balewski/plant_lineFollower/docs/line_folower_figs/section_electrical_robot.tex

\clearpage
\section{Electrical Connections and Onboard I/O}
\label{sec:electrical-design}
\subsection{Shared Battery and Two Power Rails}
The recorded wiring uses one shared two-cell 18650 pack (2S, 7.4\,V nominal), with separate 5\,V logic and 6\,V motor buck converters. S1 enables the logic branch and feeds the downstream S2 motor switch. Opening S2 removes motor power while leaving computing and sensing powered. Desktop and ASUS use their own external supplies.

\begin{figure}[H]
\centering
\input{current_robot_power.tikz}
\caption{Current power topology. One battery feeds two converters; this replaces the earlier independent-power-bank concept. Grounds join on the load side of the return ammeter. Pi--Teensy control data uses 3.3\,V UART, not USB CDC.}
\label{fig:power_topology}
\end{figure}

The 5\,V output feeds Pi, Teensy Vin and all three sensor VCC inputs in parallel. Teensy's USB power bridge is cut to isolate VUSB from Vin. Teensy 3.3\,V feeds TB6612FNG VCC; the 6\,V buck feeds VM. Motor leads connect across each bridge's two outputs, not to ground. Converter capacity, motor stall current and pack discharge performance remain uncharacterized in this record.

All signal grounds share a reference. Route motor current back to the motor buck rather than through Teensy or sensor ground leads. The detailed diagram omits charging/protection and bypass components. Retain the documented local bypassing and motor suppression; the earlier recommendation was a 470--1000\,$\mu$F motor-rail bulk capacitor and 0.1\,$\mu$F across each motor, not a measured inventory of fitted parts.

\clearpage
\subsection{Pi, Teensy and Motor-Driver Wiring}
\begin{figure}[H]
\centering
\resizebox{.86\linewidth}{!}{\input{pi_teensy_tb6612_wiring.tikz}}
\caption{Pin-level motor wiring, timing connection and indicator LEDs. Channel A drives the left wheel; channel B drives the right wheel. Teensy pin 20 connects through 5\,k$\Omega$ to Pi GPIO23 (header pin 16) for shared-edge timing. Pi GPIO24 (header pin 18) and Teensy pin 21 each drive a separate grounded LED through 5\,k$\Omega$. S1 and S2 are cascaded; all grounds join the ammeter's load side.}
\label{fig:pi-teensy-tb6612-wiring}
\end{figure}

Pi GPIO14/TX (header pin 8) connects to Teensy pin 0/RX1. Pi GPIO15/RX (header pin 10) connects to Teensy pin 1/TX1. Both are 3.3\,V signals, with common ground. The current client opens \texttt{/dev/serial0} at 115200 baud, 8N1. USB is retained as a programming option, not the normal control-data path.

The timing wire is separate from UART: Teensy pin 20 is the pulse output and Pi GPIO23 is the input. Each indicator LED has its anode connected through its own 5\,k$\Omega$ resistor to its GPIO output and its cathode connected to common ground. Firmware revision 16 retains the standalone \texttt{measure\_pi\_teensy\_clock} test: both LEDs flash twice (0.5\,s on, 0.5\,s off), then numbered timing pulses compare Teensy timestamps with Pi kernel GPIO-event timestamps. Motors remain disabled. The reported offset applies no latency correction; the assumed 0.1\,ms allowance is not an independently verified accuracy bound.

\begin{table}[H]
\centering\small
\caption{Current dual-motor GPIO allocation in firmware revision 9.}
\label{tab:current-motor-pins}
\begin{tabular}{@{}L{4cm}L{3cm}L{9cm}@{}}
\toprule
Function & Teensy pins & Behavior \\
\midrule
Left motor A & PWM 3; direction 4, 5 & Signed command $-255\ldots255$; hardware PWM 20\,kHz. \\
Right motor B & PWM 9; direction 7, 8 & Signed command $-255\ldots255$; hardware PWM 20\,kHz. \\
Common standby & 6 & LOW disables both bridges; \texttt{STOPALL} enters standby. \\
Logic / motor power & 3.3\,V to VCC / 6\,V to VM & Separate supply pins; common ground. \\
\bottomrule
\end{tabular}
\end{table}
Physical wheel polarity is a configuration value (currently \texttt{rr}), applied after computing signed physical-direction targets. PWM is open-loop power control; wheel speed and rotation are not measured by this program. The firmware starts stopped and has a 750\,ms drive-command watchdog. ADC queries do not refresh it. A stop disables drive; mechanical coasting time is additional.

\clearpage
\subsection{Three Reflectance Sensors}
\begin{figure}[H]
\centering
\resizebox{.96\linewidth}{!}{\input{pi_teensy_tcrt5000_wiring.tikz}}
\caption{Current A/B/C sensor wiring: analog outputs to Teensy GPIO 25/26/27 (A11/A12/A13); shared 5\,V sensor power and common ground. DO is unused. The 5\,V supply does not establish AO compatibility: Teensy ADC inputs must remain within 0--3.3\,V. No attenuation circuit is shown.}
\label{fig:pi-teensy-tcrt5000-wiring}
\end{figure}

\texttt{ADC3} reads A, B and C sequentially with 10-bit resolution and returns \texttt{ADC3 A B C}, with each count in 0--1023. Firmware revision 9 performs neither reflectance normalization nor an acquisition timestamp. The installed calibration assumes black gives higher counts than white; validate this on the actual floor and tape. Sensor calibration is documented in Appendix~\ref{app:photo3-calibration}.

No independent emitter switching or emitter-off subtraction is implemented. Lighting, working height and saturation can affect calibration. The \href{https://www.pjrc.com/store/teensy41.html}{Teensy specification} gives a 0--3.3\,V analog-input range without 5\,V tolerance; the earlier bench acquisition test did not establish the full AO voltage range of the powered modules. Historical readout and motor tests are in Appendix~\ref{app:bench-history}.
