balewski/plant_lineFollower/docs/line_folower_figs/figures/cad_sep15_exploded.png

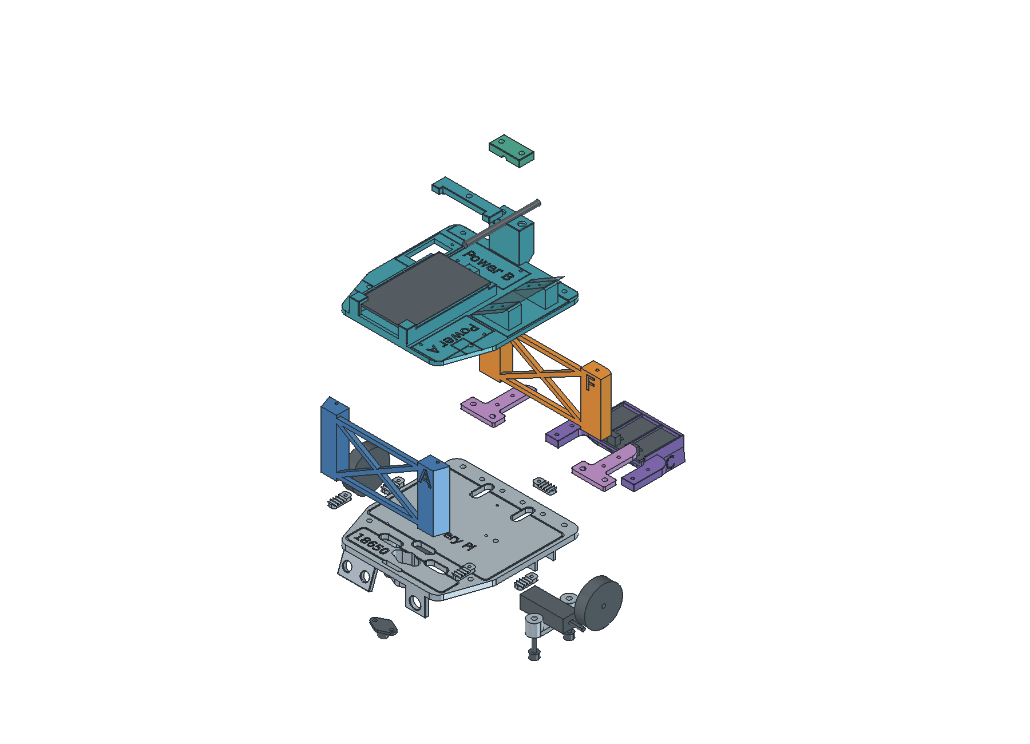
docs/line_folower_figs/figures/cad_sep15_exploded.png
