balewski/plant_lineFollower/docs/line_folower_figs/figures/cad_sep15_assembled.png

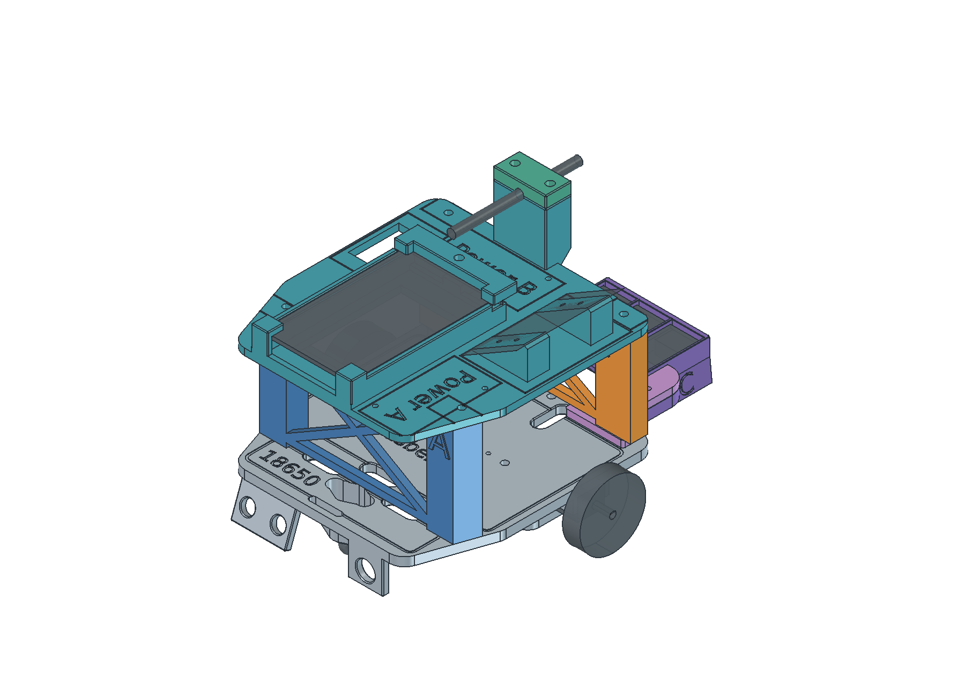
docs/line_folower_figs/figures/cad_sep15_assembled.png
