balewski/plant_lineFollower/docs/line_folower_figs/figures/desktop_clock/result_table.tex

\begin{tabular}{@{}lrrrrrr@{}}
\toprule
Run & Active (s) & Cycles & $T\to D$ & $D\to T$ & Round trip & Max. $\pm u$ \\
\midrule
25 Hz & 7.9 & 198 & 5.4 & 2.7 & 8.2 & 2.4 \\
50 Hz & 8.0 & 392 & 5.2 & 2.7 & 8.1 & 2.6 \\
100 Hz & 8.0 & 770 & 5.6 & 2.6 & 8.3 & 2.4 \\
50 Hz, padded & 4.0 & 186 & 5.4 & 4.8 & 10.3 & 2.4 \\
\bottomrule
\end{tabular}
