balewski/plant_lineFollower/docs/line_folower_figs/figures/gpio_clock/result_table.tex

\begin{tabular}{@{}L{8.3cm}rr@{}}
\toprule
Quantity & Idle & CPU load \\
\midrule
Matched / requested edges & 1000 / 1000 & 1000 / 1000 \\
Elapsed time, including startup (s) & 52.98 & 53.47 \\
Pi reference time (s) & 2282.586009 & 2491.321708 \\
Nominal Pi--Teensy offset at reference (s) & 2188.464122723 & 2188.464834611 \\
Fitted drift ($\mu$s/s = ppm) & +3.339 & +3.186 \\
Residual Q1 / median / Q3 ($\mu$s) & -1.9 / -1.1 / +0.1 & -1.6 / -0.6 / +0.4 \\
Residual minimum / maximum ($\mu$s) & -5.5 / +67.9 & -7.4 / +34.2 \\
Residual full range ($\mu$s) & 73.4 & 41.6 \\
Maximum Teensy bracket ($\mu$s) & 1.0 & 1.0 \\
Median kernel-event-to-userspace delay ($\mu$s) & 147.0 & 156.0 \\
\bottomrule
\end{tabular}
