balewski/plant_lineFollower/(commit log)

2026-10-05 Add the Teensy pin 29 blink toy and its firmware sketch.
2026-10-11 Add the distributed line-follower run and match the rewired Teensy pins.
    Desktop runs skip the Pi-Teensy clock measurement unless --timingTeensyPi is set, and wheel speed uses the same 0-255 PWM range as the local follower.
2026-10-11 Send the Pi calibration files to the operator over UDP.
    The controller reads boot, clock, and photo3 JSON at job start, so the desktop run no longer copies them with scp. Calibrations keep the printed summary, and the follower uses the sensor means and standard deviations.
2026-10-11 Record the October 11 clock measurement and the UDP calibration handoff.
2026-10-11 Add runOperatorVideo and draw the telemetry banner from the current transmit measurement.
